giovannitarter/automatic_irrigation/board/mk2/automatic_irrigation_project/automatic_irrigation_project.pdf

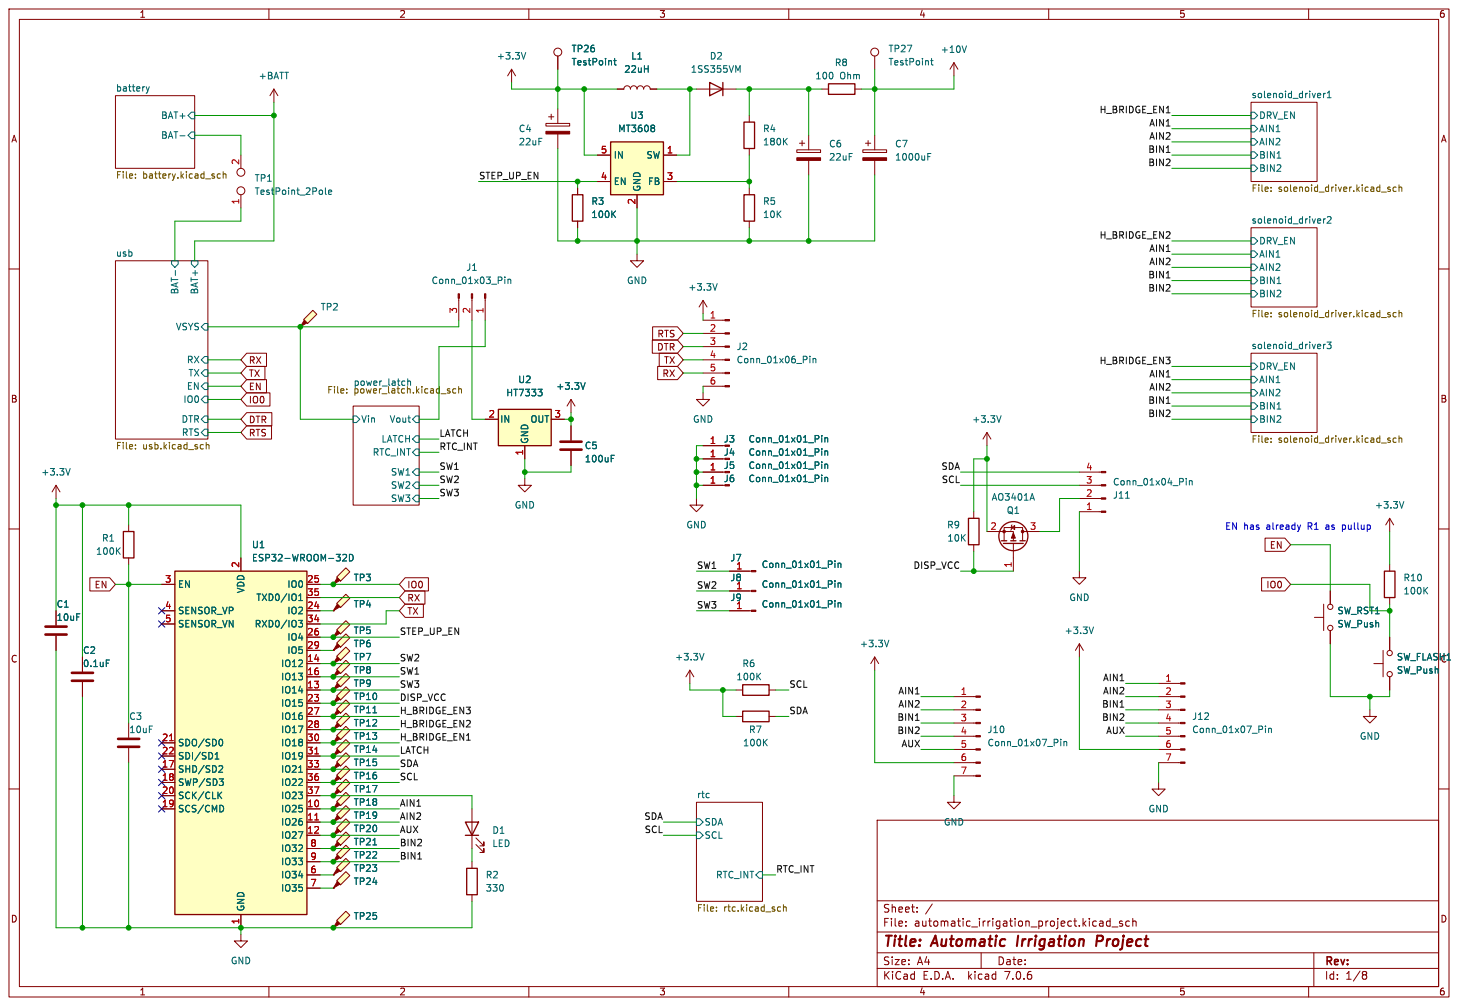
[picture p1: page 1]

2 SCK/CLK 20 SDO/SD0 21 SDI/SD1 22

Id: 1/8 Title: Automatic Irrigation Project File: automatic_irrigation_project.kicad_sch Sheet: /

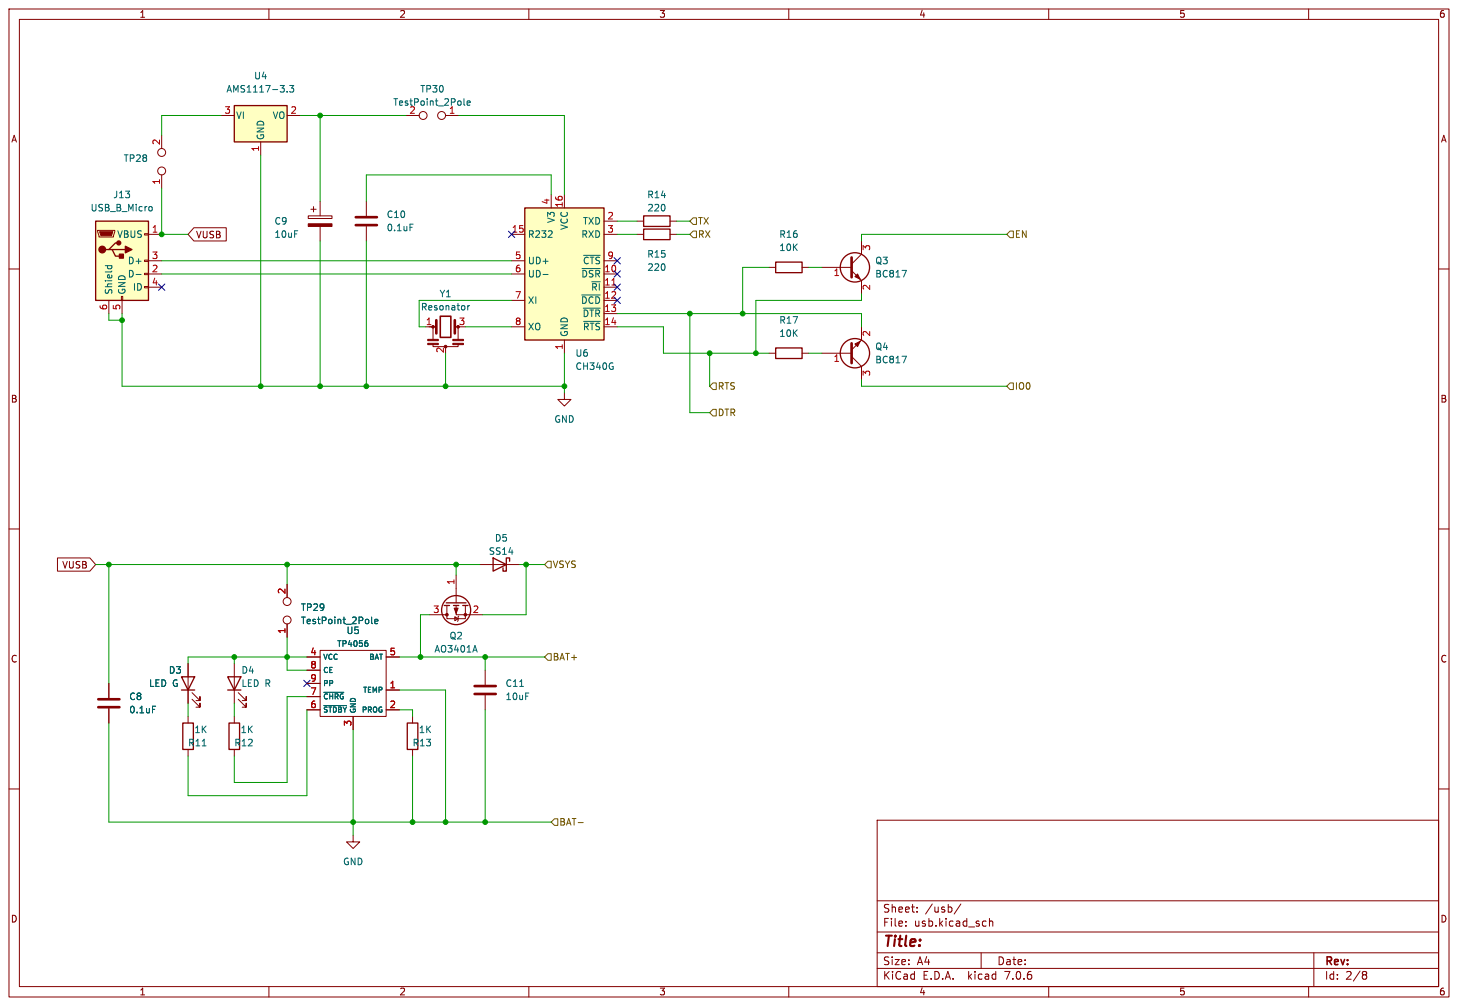
[picture p2: page 2]

1 ~{DSR} 10 ~{RI} 11 ~{DCD} 12 ~{DTR} 13 ~{RTS} 14 R232 15 VCC 16 TXD 2 RXD 3 V3

4 UD+ 5 UD- 6 XI 7 XO 8 ~{CTS}9 U6 CH340G

Id: 2/8 Title: File: usb.kicad_sch Sheet: /usb/

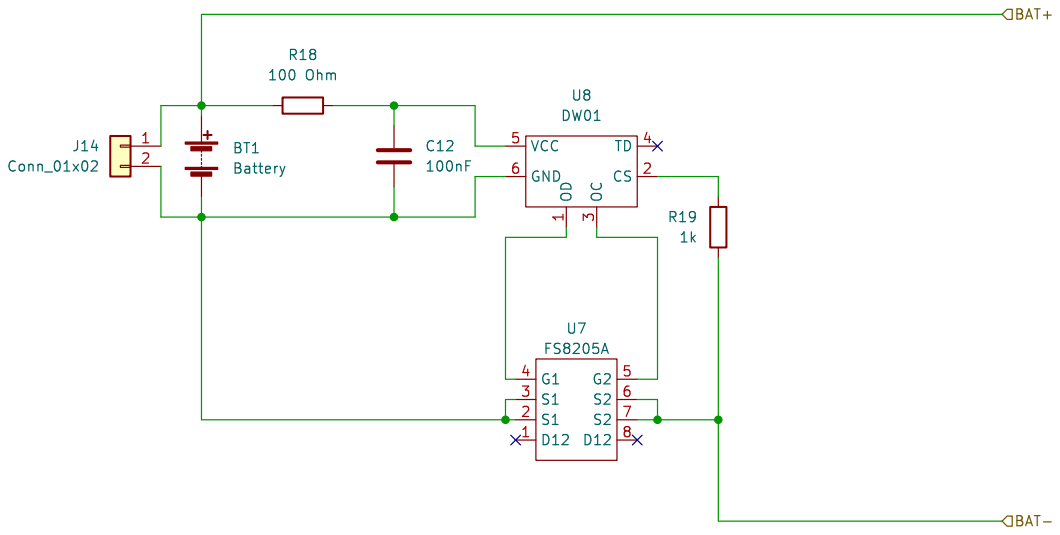
[picture p3: page 3]

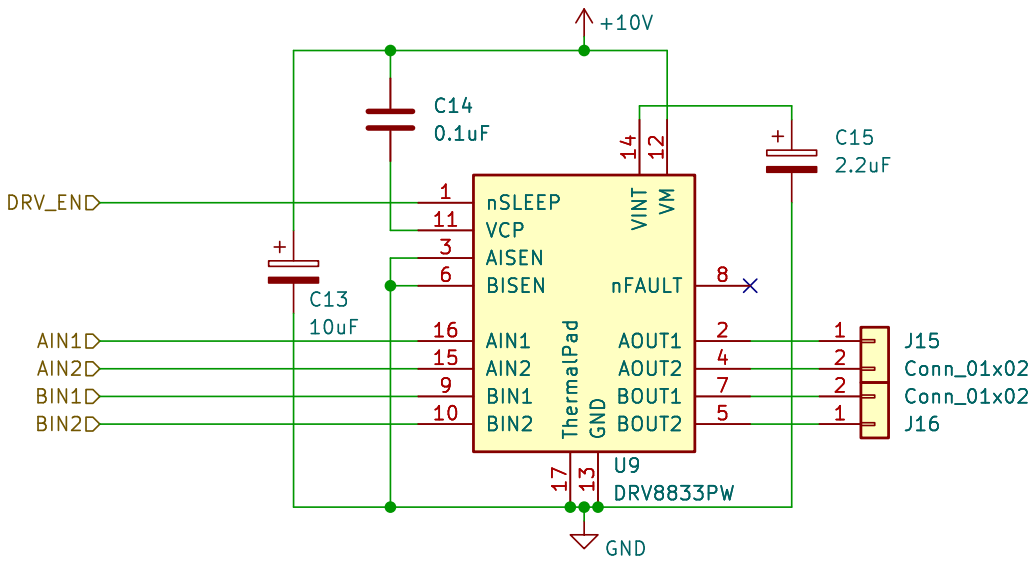
[picture p4: page 4]

Id: 4/8 Title: File: solenoid_driver.kicad_sch Sheet: /solenoid_driver1/ C13

2 2
1 1

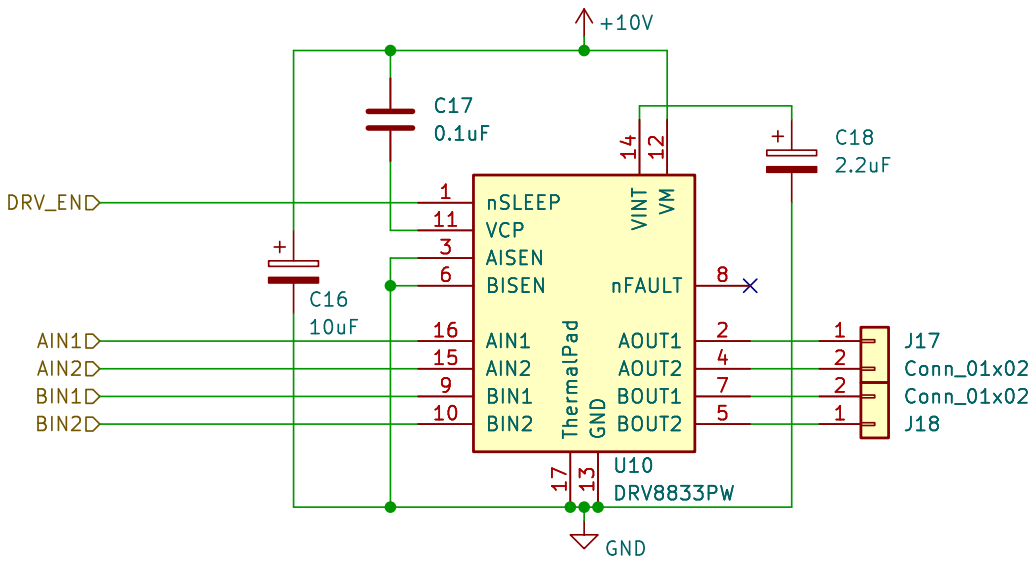
[picture p5: page 5]

Id: 5/8 Title: File: solenoid_driver.kicad_sch Sheet: /solenoid_driver2/ C16

2 2
1 1

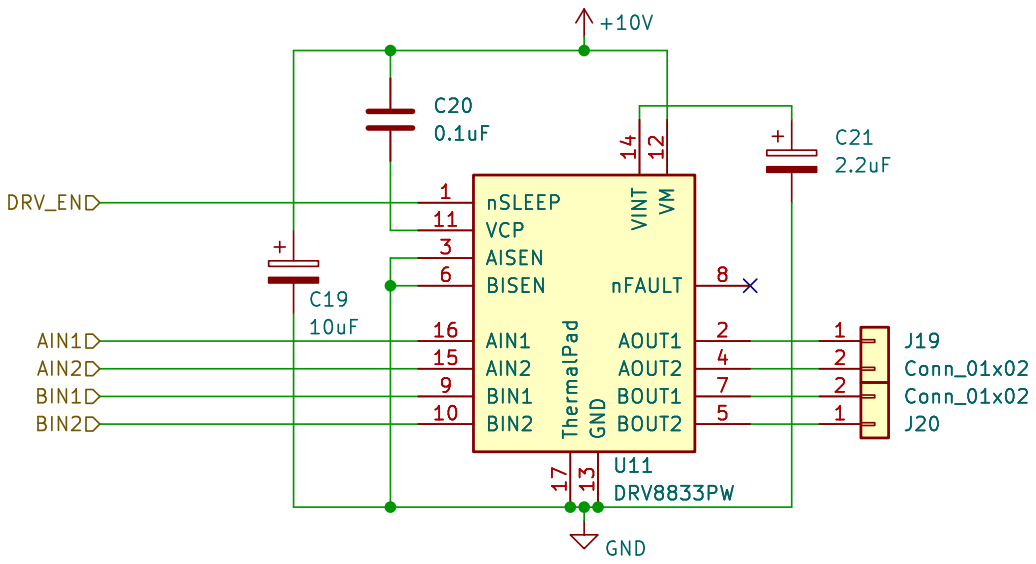
[picture p6: page 6]

Id: 6/8 Title: File: solenoid_driver.kicad_sch Sheet: /solenoid_driver3/ C19

2 2
1 1

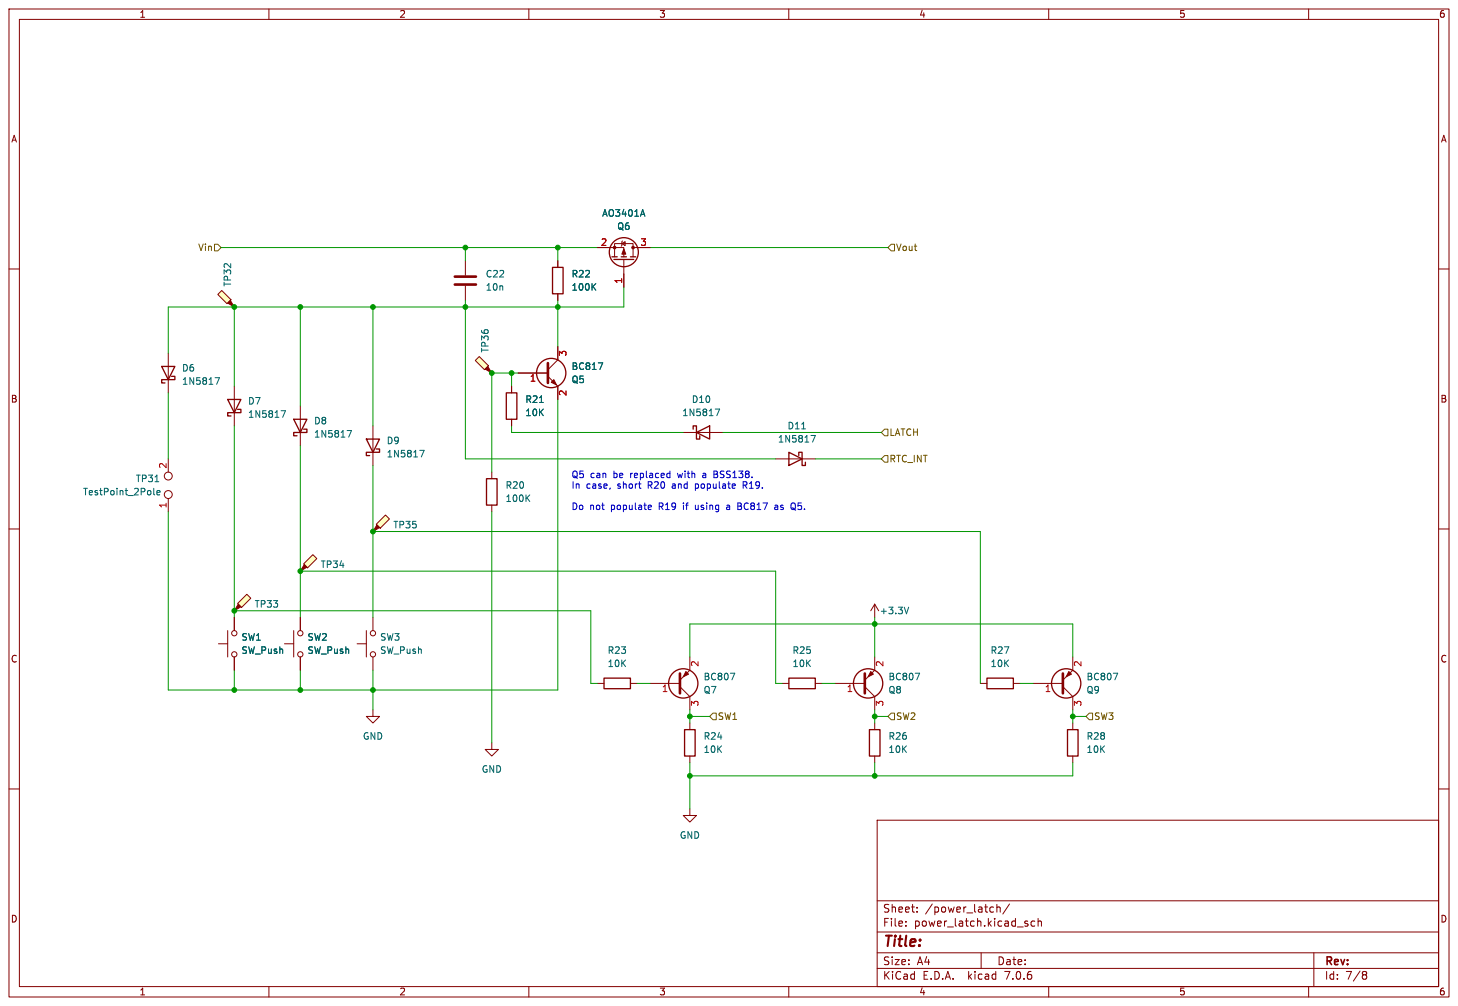
[picture p7: page 7]

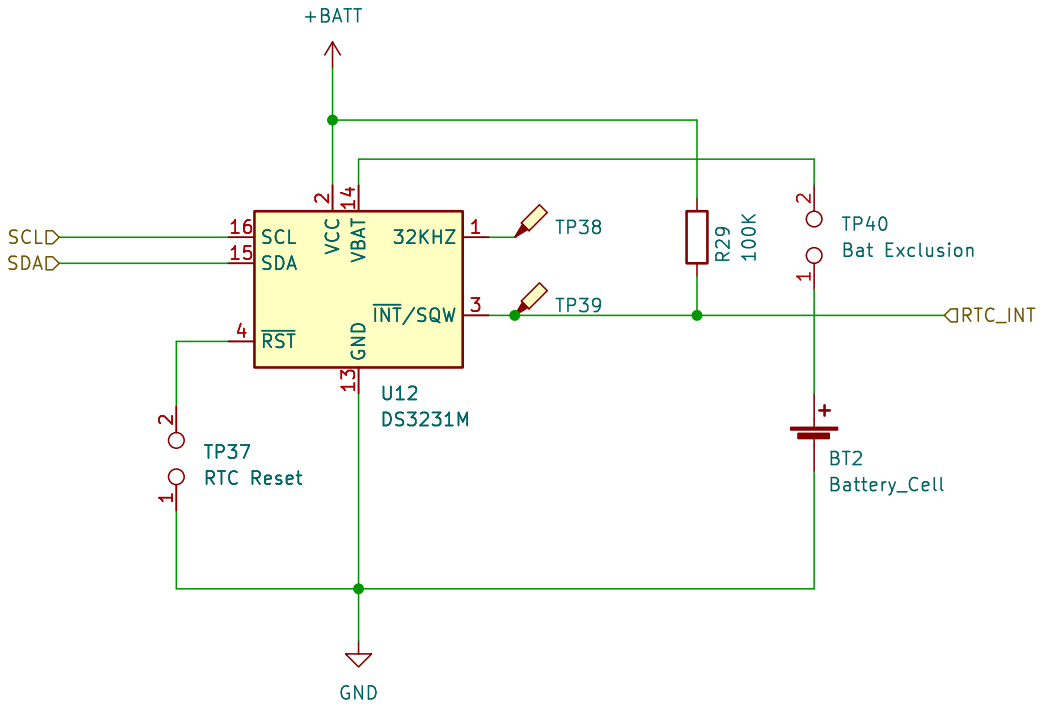
[picture p8: page 8]

Id: 8/8 Title: File: rtc.kicad_sch Sheet: /rtc/
