giovannitarter/automatic_irrigation/board/mk1/garden_valve_controller/garden_valve_controller.pdf

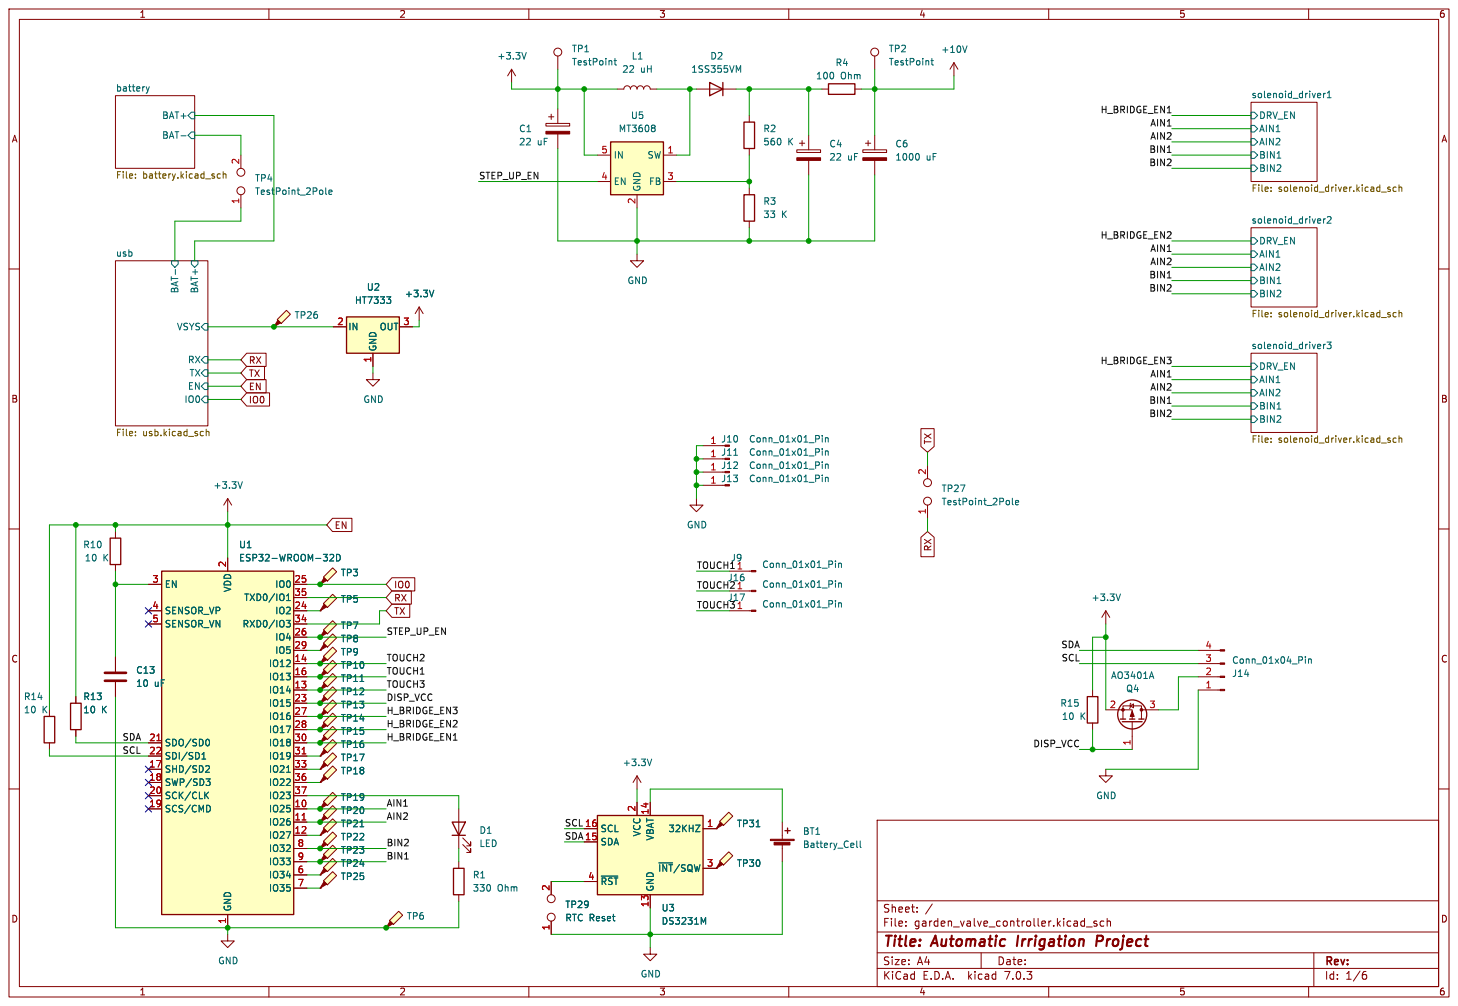
[picture p9: page 1]

2 SCK/CLK 20 SDO/SD0 21 SDI/SD1 22

2 ~{INT}/SQW3 ~{RST} 4 TP29 RTC Reset 1 2

Id: 1/6 Title: Automatic Irrigation Project File: garden_valve_controller.kicad_sch Sheet: /

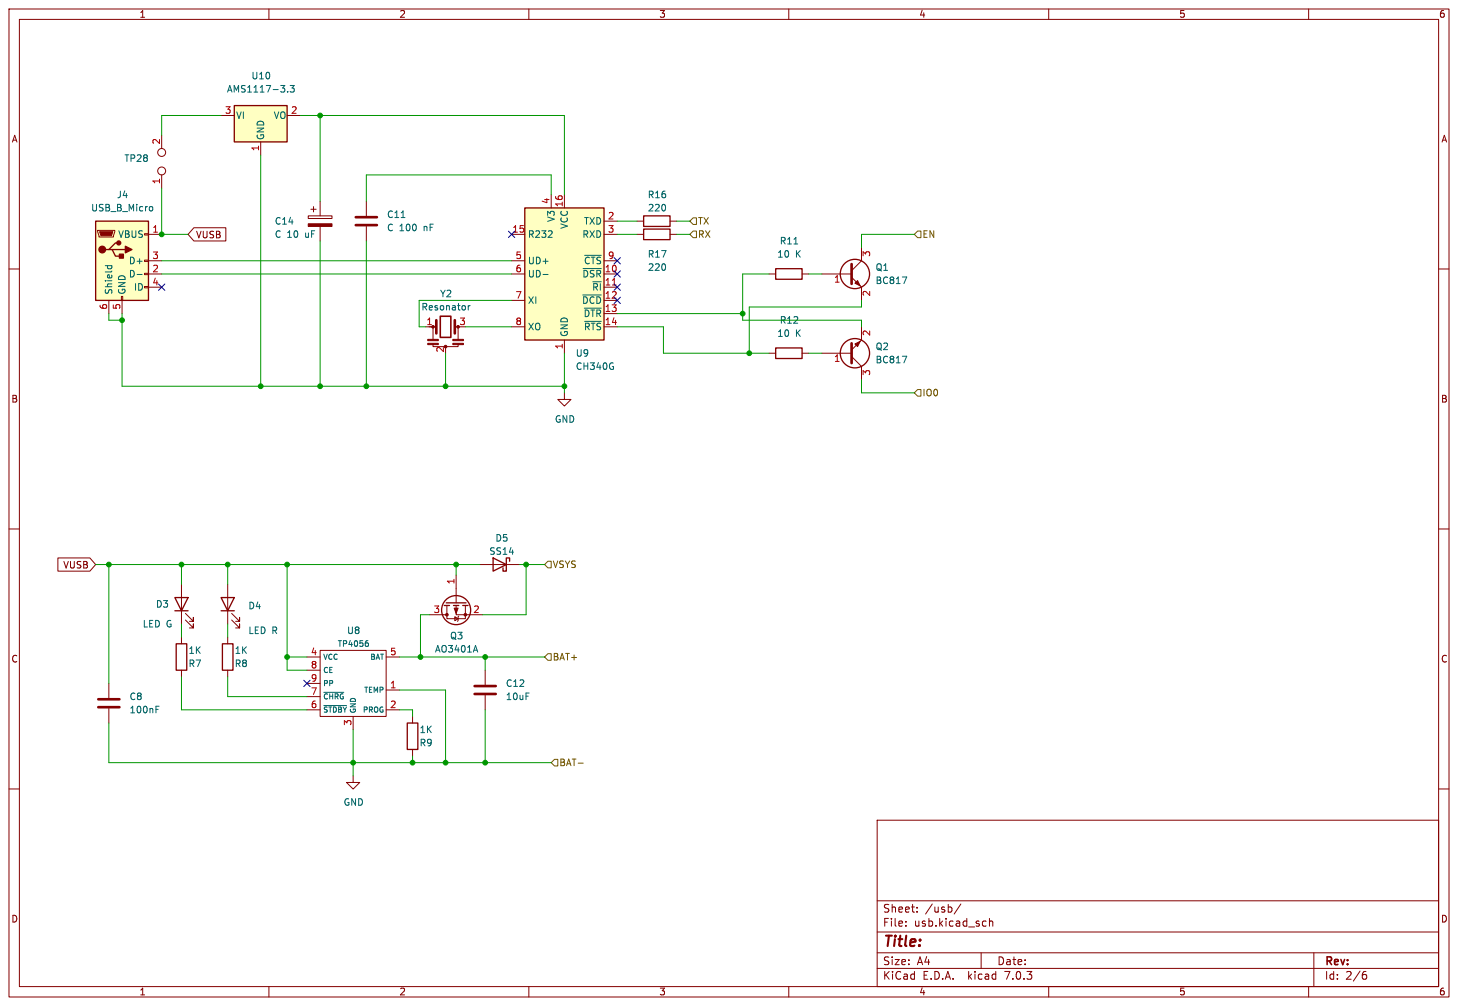
[picture p10: page 2]

1 ~{DSR} 10 ~{RI} 11 ~{DCD} 12 ~{DTR} 13 ~{RTS} 14 R232 15 VCC 16 TXD 2 RXD 3 V3

4 UD+ 5 UD- 6 XI 7 XO 8 ~{CTS}9 U9 CH340G

Id: 2/6 Title: File: usb.kicad_sch Sheet: /usb/

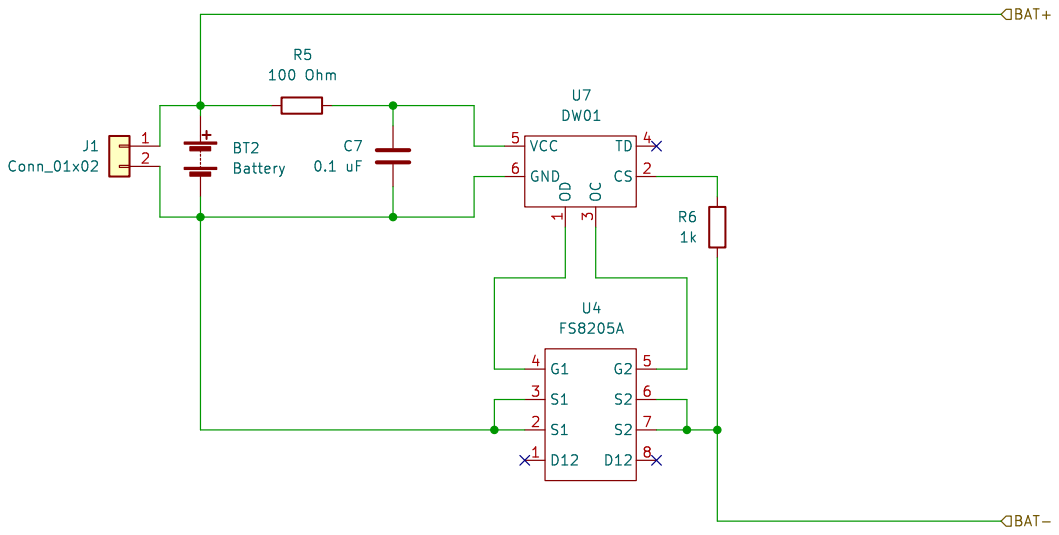
[picture p11: page 3]

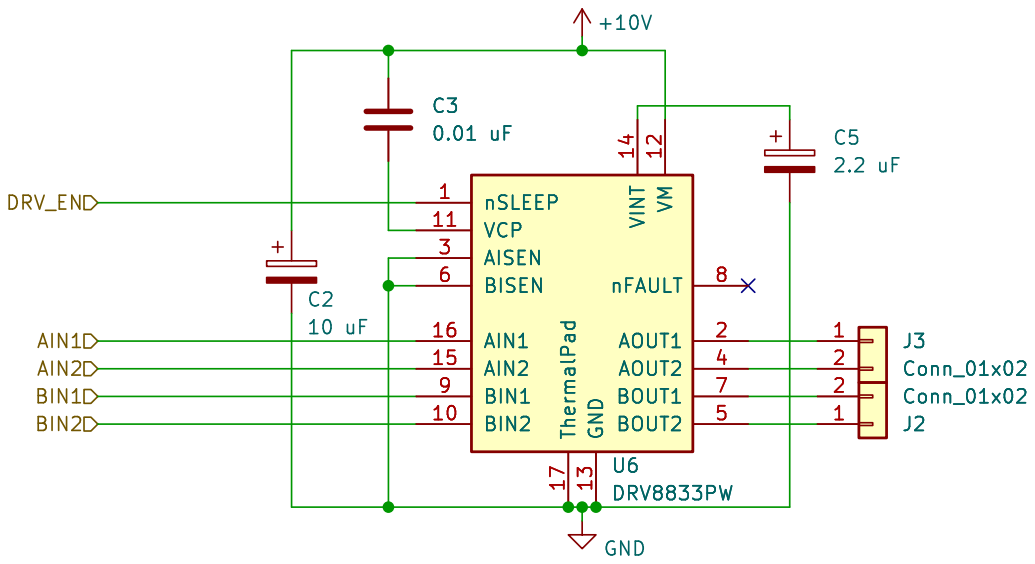
[picture p12: page 4]

Id: 4/6 Title: File: solenoid_driver.kicad_sch Sheet: /solenoid_driver1/ C2

2 2
1 1

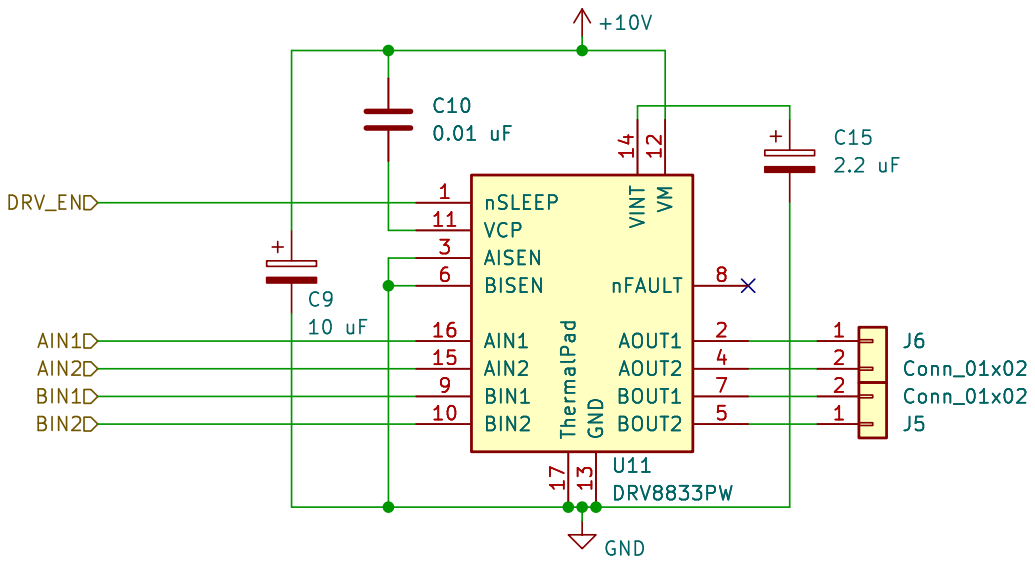
[picture p13: page 5]

Id: 5/6 Title: File: solenoid_driver.kicad_sch Sheet: /solenoid_driver2/ C9

2 2
1 1

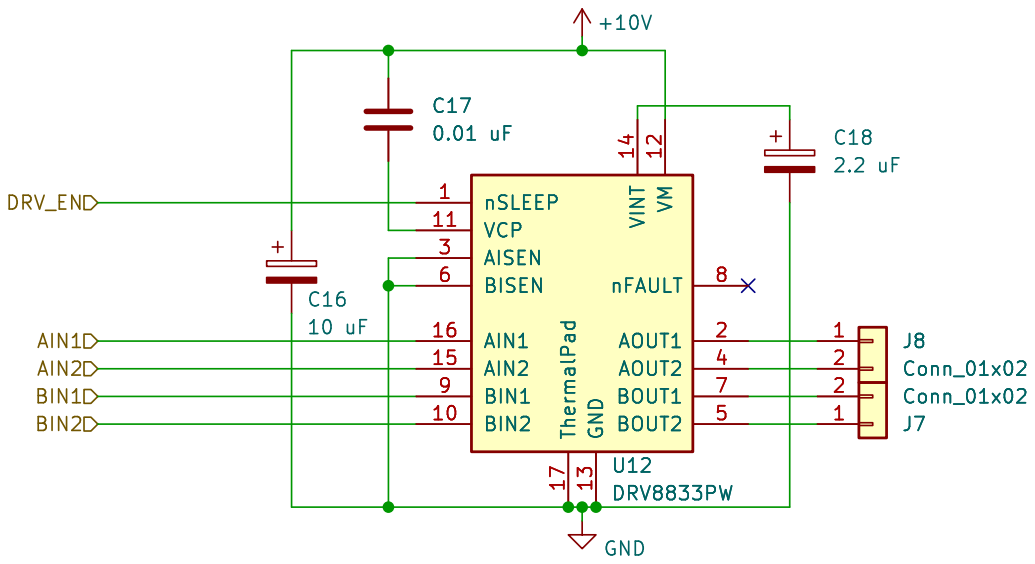
[picture p14: page 6]

Id: 6/6 Title: File: solenoid_driver.kicad_sch Sheet: /solenoid_driver3/ C16

2 2
1 1
