giovannitarter/automatic_irrigation/board/mk2/automatic_irrigation_project/automatic_irrigation_project.kicad_pcb

## KiCad design board/mk2/automatic_irrigation_project/automatic_irrigation_project.kicad_pcb (2023-07-23)

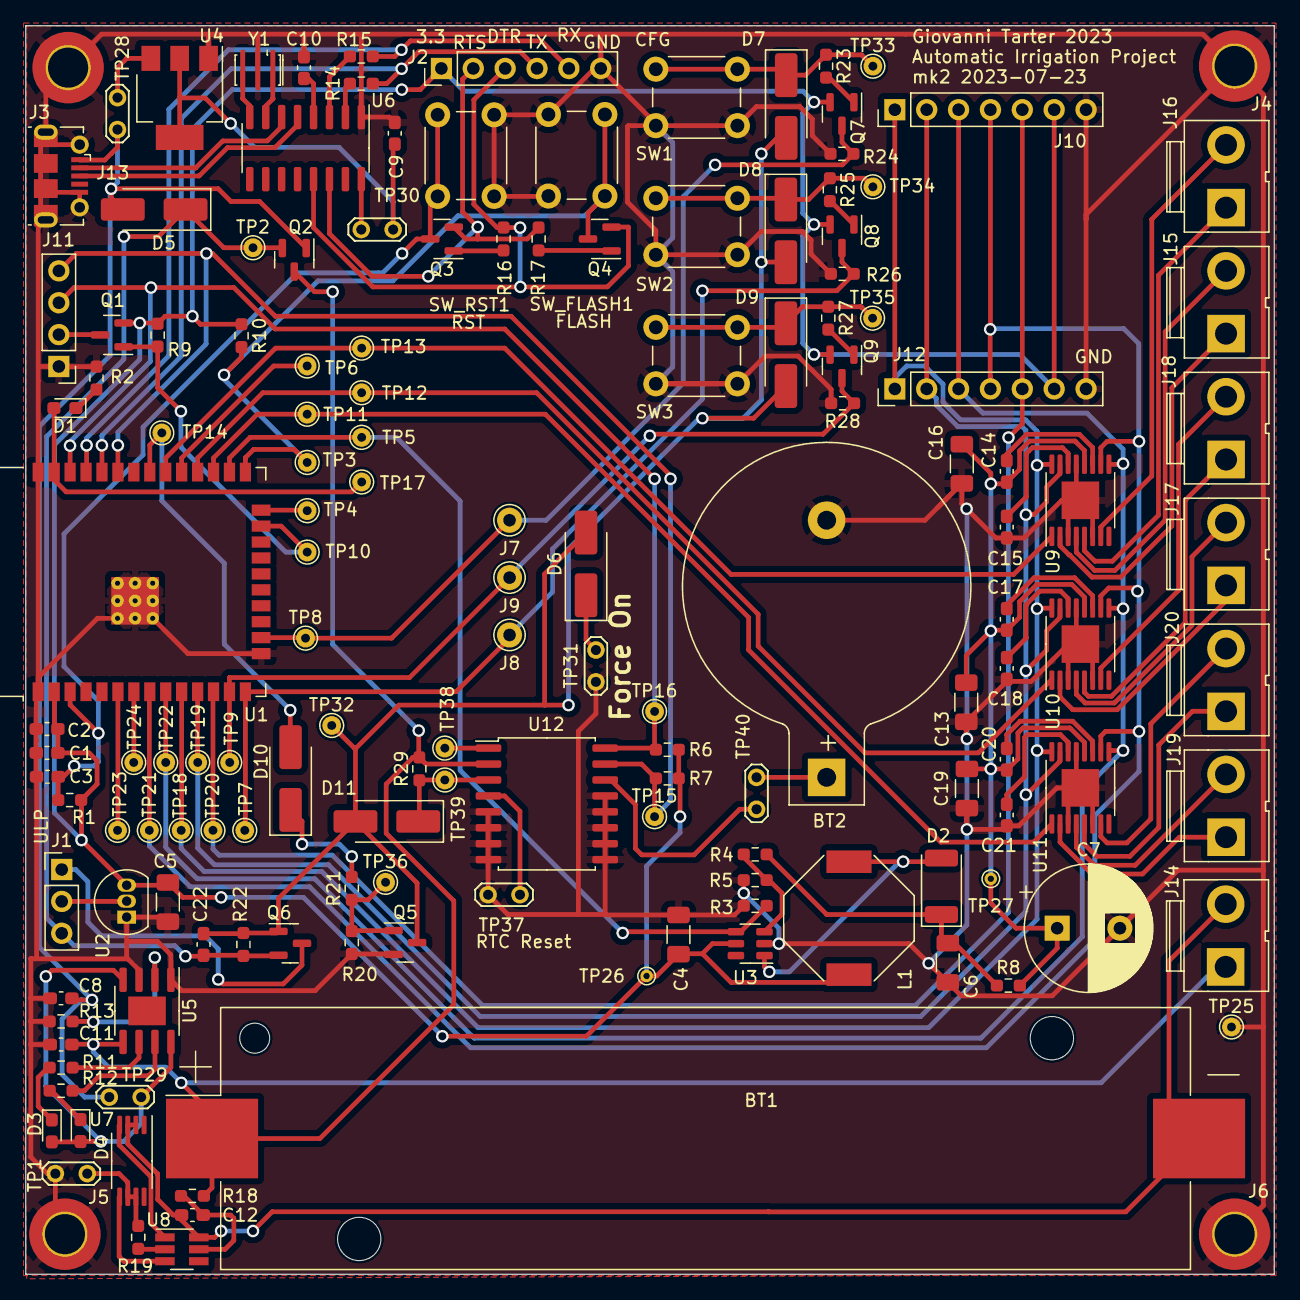
[picture p15: board automatic_irrigation_project.kicad_pcb from above]

Board: 2 copper layers, 99.5 x 99.5 mm, 152 parts (0 on the bottom side), 97 nets.

Parts:
BT1: Battery; BatteryHolder_Keystone_1042_1x18650
BT2: Battery_Cell; BatteryHolder_Keystone_103_1x20mm
C1, C3, C9, C11: 10uF; C_0603_1608Metric_Pad1.08x0.95mm_HandSolder
C2, C8, C10, C14, C17, C20: 0.1uF; C_0603_1608Metric_Pad1.08x0.95mm_HandSolder
C4, C6: 22uF; C_1206_3216Metric_Pad1.33x1.80mm_HandSolder
C5: 100uF; C_1206_3216Metric_Pad1.33x1.80mm_HandSolder
C7: 1000uF; CP_Radial_D10.0mm_P5.00mm
C12: 100nF; C_0603_1608Metric_Pad1.08x0.95mm_HandSolder
C13, C16, C19: 10uF; C_1206_3216Metric_Pad1.33x1.80mm_HandSolder
C15, C18, C21: 2.2uF; C_0603_1608Metric_Pad1.08x0.95mm_HandSolder
C22: 10n; C_0603_1608Metric_Pad1.08x0.95mm_HandSolder
D1: LED; LED_0603_1608Metric_Pad1.05x0.95mm_HandSolder
D2: 1SS355VM; D_2010_5025Metric
D3: LED G; LED_0603_1608Metric_Pad1.05x0.95mm_HandSolder
D4: LED R; LED_0603_1608Metric_Pad1.05x0.95mm_HandSolder
D5: SS14; D_SMA_Handsoldering
D6, D7, D8, D9, D10, D11: 1N5817; D_SMA_Handsoldering
J1: Conn_01x03_Pin; PinHeader_1x03_P2.54mm_Vertical
J2: Conn_01x06_Pin; PinHeader_1x06_P2.54mm_Vertical
J3, J4, J5, J6: Conn_01x01_Pin; MountingHole_3.2mm_M3_ISO7380_Pad_TopBottom
J7, J8, J9: Conn_01x01_Pin; Pin_D1.0mm_L10.0mm
J10, J12: Conn_01x07_Pin; PinHeader_1x07_P2.54mm_Vertical
J11: Conn_01x04_Pin; PinHeader_1x04_P2.54mm_Vertical
J13: USB_B_Micro; USB_Micro-B_Molex-105017-0001
J14, J15, J16, J17, J18, J19, J20: Conn_01x02; Terminal_5mm
L1: 22uH; L_Bourns-SRU1028_10.0x10.0mm
Q1, Q2, Q6: AO3401A; SOT-23
Q3, Q4, Q5: BC817; SOT-23
Q7, Q8, Q9: BC807; SOT-23
R1, R3, R6, R7, R10, R20, R22, R29: 100K; R_0603_1608Metric_Pad0.98x0.95mm_HandSolder
R2: 330; R_0603_1608Metric_Pad0.98x0.95mm_HandSolder
R4: 180K; R_0603_1608Metric_Pad0.98x0.95mm_HandSolder
R5, R9, R16, R17, R21, R23, R24, R25, R26, R27, R28: 10K; R_0603_1608Metric_Pad0.98x0.95mm_HandSolder
R8, R18: 100 Ohm; R_0603_1608Metric_Pad0.98x0.95mm_HandSolder
R11, R12, R13: 1K; R_0603_1608Metric_Pad0.98x0.95mm_HandSolder
R14, R15: 220; R_0603_1608Metric_Pad0.98x0.95mm_HandSolder
R19: 1k; R_0603_1608Metric_Pad0.98x0.95mm_HandSolder
SW1, SW2, SW3: SW_Push; SW_PUSH_6mm_H4.3mm
SW_FLASH1: SW_Push; SW_PUSH_6mm_H4.3mm
SW_RST1: SW_Push; SW_PUSH_6mm_H4.3mm
TP1, TP28, TP29, TP30, TP31: TestPoint_2Pole; TestPoint_2Pads_Pitch2.54mm_Drill0.8mm
TP2, TP3, TP4, TP5, TP6, TP7, TP8, TP9, TP10, TP11, TP12, TP13, TP14, TP15, TP16, TP17, TP18, TP19, TP20, TP21, TP22, TP23, TP24, TP25, TP32, TP33, TP34, TP35, TP36, TP38, TP39: TestPoint_Probe; TestPoint_THTPad_D1.5mm_Drill0.7mm
TP26, TP27: TestPoint; TestPoint_THTPad_D1.0mm_Drill0.5mm
TP37: RTC Reset; TestPoint_2Pads_Pitch2.54mm_Drill0.8mm
TP40: Bat Exclusion; TestPoint_2Pads_Pitch2.54mm_Drill0.8mm
U1: ESP32-WROOM-32D
U2: HT7333; TO-92L_Inline
U3: MT3608; SOT-23-6
U4: AMS1117-3.3; SOT-223-3_TabPin2
U5: TP4056; SOIC-8-1EP_3.9x4.9mm_P1.27mm_EP2.29x3mm
U6: CH340G; SOIC-16_3.9x9.9mm_P1.27mm
U7: FS8205A; TSSOP-8_4.4x3mm_P0.65mm
U8: DW01; SOT-23-6_Handsoldering
U9, U10, U11: DRV8833PW; HTSSOP-16-1EP_4.4x5mm_P0.65mm_EP3x3mm
U12: DS3231M; SOIC-16W_7.5x10.3mm_P1.27mm
Y1: Resonator; Resonator_SMD_Murata_CSTxExxV-3Pin_3.0x1.1mm_HandSoldering

Connections:
+3.3V: C1.1, C2.1, C4.1, C5.1, J2.1, J10.6, J12.6, L1.1, Q1.2 (S), Q7.2 (E), Q8.2 (E), Q9.2 (E), R1.2, R6.1, R7.1, R9.2, R10.1, TP26.1, U1.2 (VDD), U2.3 (OUT), U3.5 (IN)
+10V: C7.1, C13.1, C14.1, C16.1, C17.1, C19.1, C20.1, R8.2, TP27.1, U9.12 (VM), U10.12 (VM), U11.12 (VM)
+BATT: BT1.1 (+), C11.1, J14.1, Q2.3 (D), R18.2, R29.2, U5.5 (BAT), U12.2 (VCC)
/AIN1: J10.1, J12.1, TP18.1, U1.10 (IO25), U9.16 (AIN1), U10.16 (AIN1), U11.16 (AIN1)
/AIN2: J10.2, J12.2, TP19.1, U1.11 (IO26), U9.15 (AIN2), U10.15 (AIN2), U11.15 (AIN2)
/AUX: J10.5, J12.5, TP20.1, U1.12 (IO27)
/BIN1: J10.3, J12.3, TP22.1, U1.9 (IO33), U9.9 (BIN1), U10.9 (BIN1), U11.9 (BIN1)
/BIN2: J10.4, J12.4, TP21.1, U1.8 (IO32), U9.10 (BIN2), U10.10 (BIN2), U11.10 (BIN2)
/DISP_VCC: Q1.1 (G), R9.1, TP10.1, U1.23 (IO15)
/H_BRIDGE_EN1: TP13.1, U1.30 (IO18), U9.1 (nSLEEP)
/H_BRIDGE_EN2: TP12.1, U1.28 (IO17), U10.1 (nSLEEP)
/H_BRIDGE_EN3: TP11.1, U1.27 (IO16), U11.1 (nSLEEP)
/LATCH: D10.2 (A), TP14.1, U1.31 (IO19)
/RTC_INT: D11.1 (K), R29.1, TP39.1, U12.3 (~INT/SQW)
/SCL: J11.3, R6.2, TP16.1, U1.36 (IO22), U12.16 (SCL)
/SDA: J11.4, R7.2, TP15.1, U1.33 (IO21), U12.15 (SDA)
/STEP_UP_EN: R3.1, TP5.1, U1.26 (IO4), U3.4 (EN)
/SW1: J7.1, Q7.3 (C), R24.1, TP8.1, U1.16 (IO13)
/SW2: J8.1, Q8.3 (C), R26.1, TP7.1, U1.14 (IO12)
/SW3: J9.1, Q9.3 (C), R28.1, TP9.1, U1.13 (IO14)
/battery/BAT-: R19.2, TP1.2, U7.6 (S2), U7.7 (S2)
/power_latch/Vin: C22.1, D5.1 (K), J1.3, Q2.2 (S), Q6.2 (S), R22.2, TP2.1
/power_latch/Vout: J1.1, Q6.3 (D)
DTR: J2.3, Q4.2 (E), R16.1, U6.13 (~DTR)
EN: C3.1, Q3.3 (C), R1.1, SW_RST1.2, U1.3 (EN)
GND: BT2.2 (-), C1.2, C2.2, C3.2, C4.2, C5.2, C6.2, C7.2, C8.2, C9.2, C10.2, C11.2, C13.2, C15.2, C16.2, C18.2, C19.2, C21.2, J2.6, J3.1, J4.1, J5.1, J6.1, J10.7, J11.1, J12.7, J13.5 (GND), J13.6 (Shield), Q5.2 (E), R2.2, R3.2, R5.2, R13.1, R20.2, R24.2, R26.2, R28.2, SW1.1, SW2.1, SW3.1, SW_FLASH1.1, SW_RST1.1, TP1.1, TP25.1, TP31.1, TP37.1, U1.1 (GND), U1.15 (GND), U1.38 (GND), U1.39 (GND), U2.1 (GND), U3.2 (GND), U4.1 (GND), U5.1 (TEMP), U5.3 (GND), U6.1 (GND), U9.3 (AISEN), U9.6 (BISEN), U9.13 (GND), U9.17 (ThermalPad), U10.3 (AISEN), U10.6 (BISEN), U10.13 (GND), U10.17 (ThermalPad), U11.3 (AISEN), U11.6 (BISEN), U11.13 (GND), U11.17 (ThermalPad), U12.5 (GND), U12.6 (GND), U12.7 (GND), U12.8 (GND), U12.9 (GND), U12.10 (GND), U12.11 (GND), U12.12 (GND), U12.13 (GND), Y1.2
IO0: Q4.3 (C), R10.2, SW_FLASH1.2, TP3.1, U1.25 (IO0)
unnamed: BT1.2 (-), C12.2, J14.2, U7.2 (S1), U7.3 (S1), U8.6 (GND)
unnamed: BT2.1 (+), TP40.1
unnamed: D1.2 (A), TP17.1, U1.37 (IO23)
unnamed: D1.1 (K), R2.1
unnamed: D2.2 (A), L1.2, U3.1 (SW)
unnamed: C6.1, D2.1 (K), R4.1, R8.1
unnamed: D3.2 (A), D4.2 (A), TP29.1, U5.4 (VCC), U5.8 (CE)
unnamed: D3.1 (K), R11.2
unnamed: D4.1 (K), R12.2
unnamed: D6.1 (K), TP31.2
unnamed: D7.1 (K), R23.1, SW1.2, TP33.1
unnamed: D8.1 (K), R25.1, SW2.2, TP34.1
unnamed: D9.1 (K), R27.1, SW3.2, TP35.1
unnamed: D10.1 (K), R21.2
unnamed: C22.2, D6.2 (A), D7.2 (A), D8.2 (A), D9.2 (A), D11.2 (A), Q5.3 (C), Q6.1 (G), R22.1, TP32.1
unnamed: J1.2, U2.2 (IN)
unnamed: J11.2, Q1.3 (D)
unnamed: J13.3 (D+), U6.5 (UD+)
unnamed: J13.2 (D-), U6.6 (UD-)
unnamed: J15.1, U9.2 (AOUT1)
unnamed: J15.2, U9.4 (AOUT2)
unnamed: J16.1, U9.5 (BOUT2)
unnamed: J16.2, U9.7 (BOUT1)
unnamed: J17.1, U10.2 (AOUT1)
unnamed: J17.2, U10.4 (AOUT2)
unnamed: J18.1, U10.5 (BOUT2)
unnamed: J18.2, U10.7 (BOUT1)
unnamed: J19.1, U11.2 (AOUT1)
unnamed: J19.2, U11.4 (AOUT2)
unnamed: J20.1, U11.5 (BOUT2)
unnamed: J20.2, U11.7 (BOUT1)
unnamed: Q3.1 (B), R16.2
unnamed: Q4.1 (B), R17.2
unnamed: Q5.1 (B), R20.1, R21.1, TP36.1
unnamed: Q7.1 (B), R23.2
unnamed: Q8.1 (B), R25.2
unnamed: Q9.1 (B), R27.2
unnamed: TP4.1, U1.24 (IO2)
unnamed: TP6.1, U1.29 (IO5)
unnamed: TP23.1, U1.6 (IO34)
unnamed: TP24.1, U1.7 (IO35)
unnamed: R4.2, R5.1, U3.3 (FB)
unnamed: TP28.2, U4.3 (VI)
unnamed: C9.1, TP30.2, U4.2 (VO)
unnamed: R13.2, U5.2 (PROG)
unnamed: R12.1, U5.7 (~CHRG)
unnamed: R11.1, U5.6 (~STDBY)
unnamed: R15.1, U6.3 (RXD)
unnamed: R14.1, U6.2 (TXD)
unnamed: C10.1, U6.4 (V3)
unnamed: TP30.1, U6.16 (VCC)
unnamed: U6.7 (XI), Y1.1
unnamed: U6.8 (XO), Y1.3
unnamed: U7.4 (G1), U8.1 (OD)
unnamed: U7.5 (G2), U8.3 (OC)
unnamed: R19.1, U8.2 (CS)
unnamed: C12.1, R18.1, U8.5 (VCC)
unnamed: C14.2, U9.11 (VCP)
unnamed: C15.1, U9.14 (VINT)
unnamed: C17.2, U10.11 (VCP)
unnamed: C18.1, U10.14 (VINT)
unnamed: C20.2, U11.11 (VCP)
unnamed: C21.1, U11.14 (VINT)
unnamed: TP38.1, U12.1 (32KHZ)
unnamed: TP40.2, U12.14 (VBAT)
unnamed: TP37.2, U12.4 (~RST)
RTS: J2.2, Q3.2 (E), R17.1, U6.14 (~RTS)
RX: J2.5, R15.2, U1.35 (TXD0/IO1)
TX: J2.4, R14.2, U1.34 (RXD0/IO3)
VUSB: C8.1, D5.2 (A), J13.1 (VBUS), Q2.1 (G), TP28.1, TP29.2
