giovannitarter/automatic_irrigation/board/mk1/garden_valve_controller/garden_valve_controller.kicad_pcb

## KiCad design board/mk1/garden_valve_controller/garden_valve_controller.kicad_pcb (2023-05-14, an earlier design)

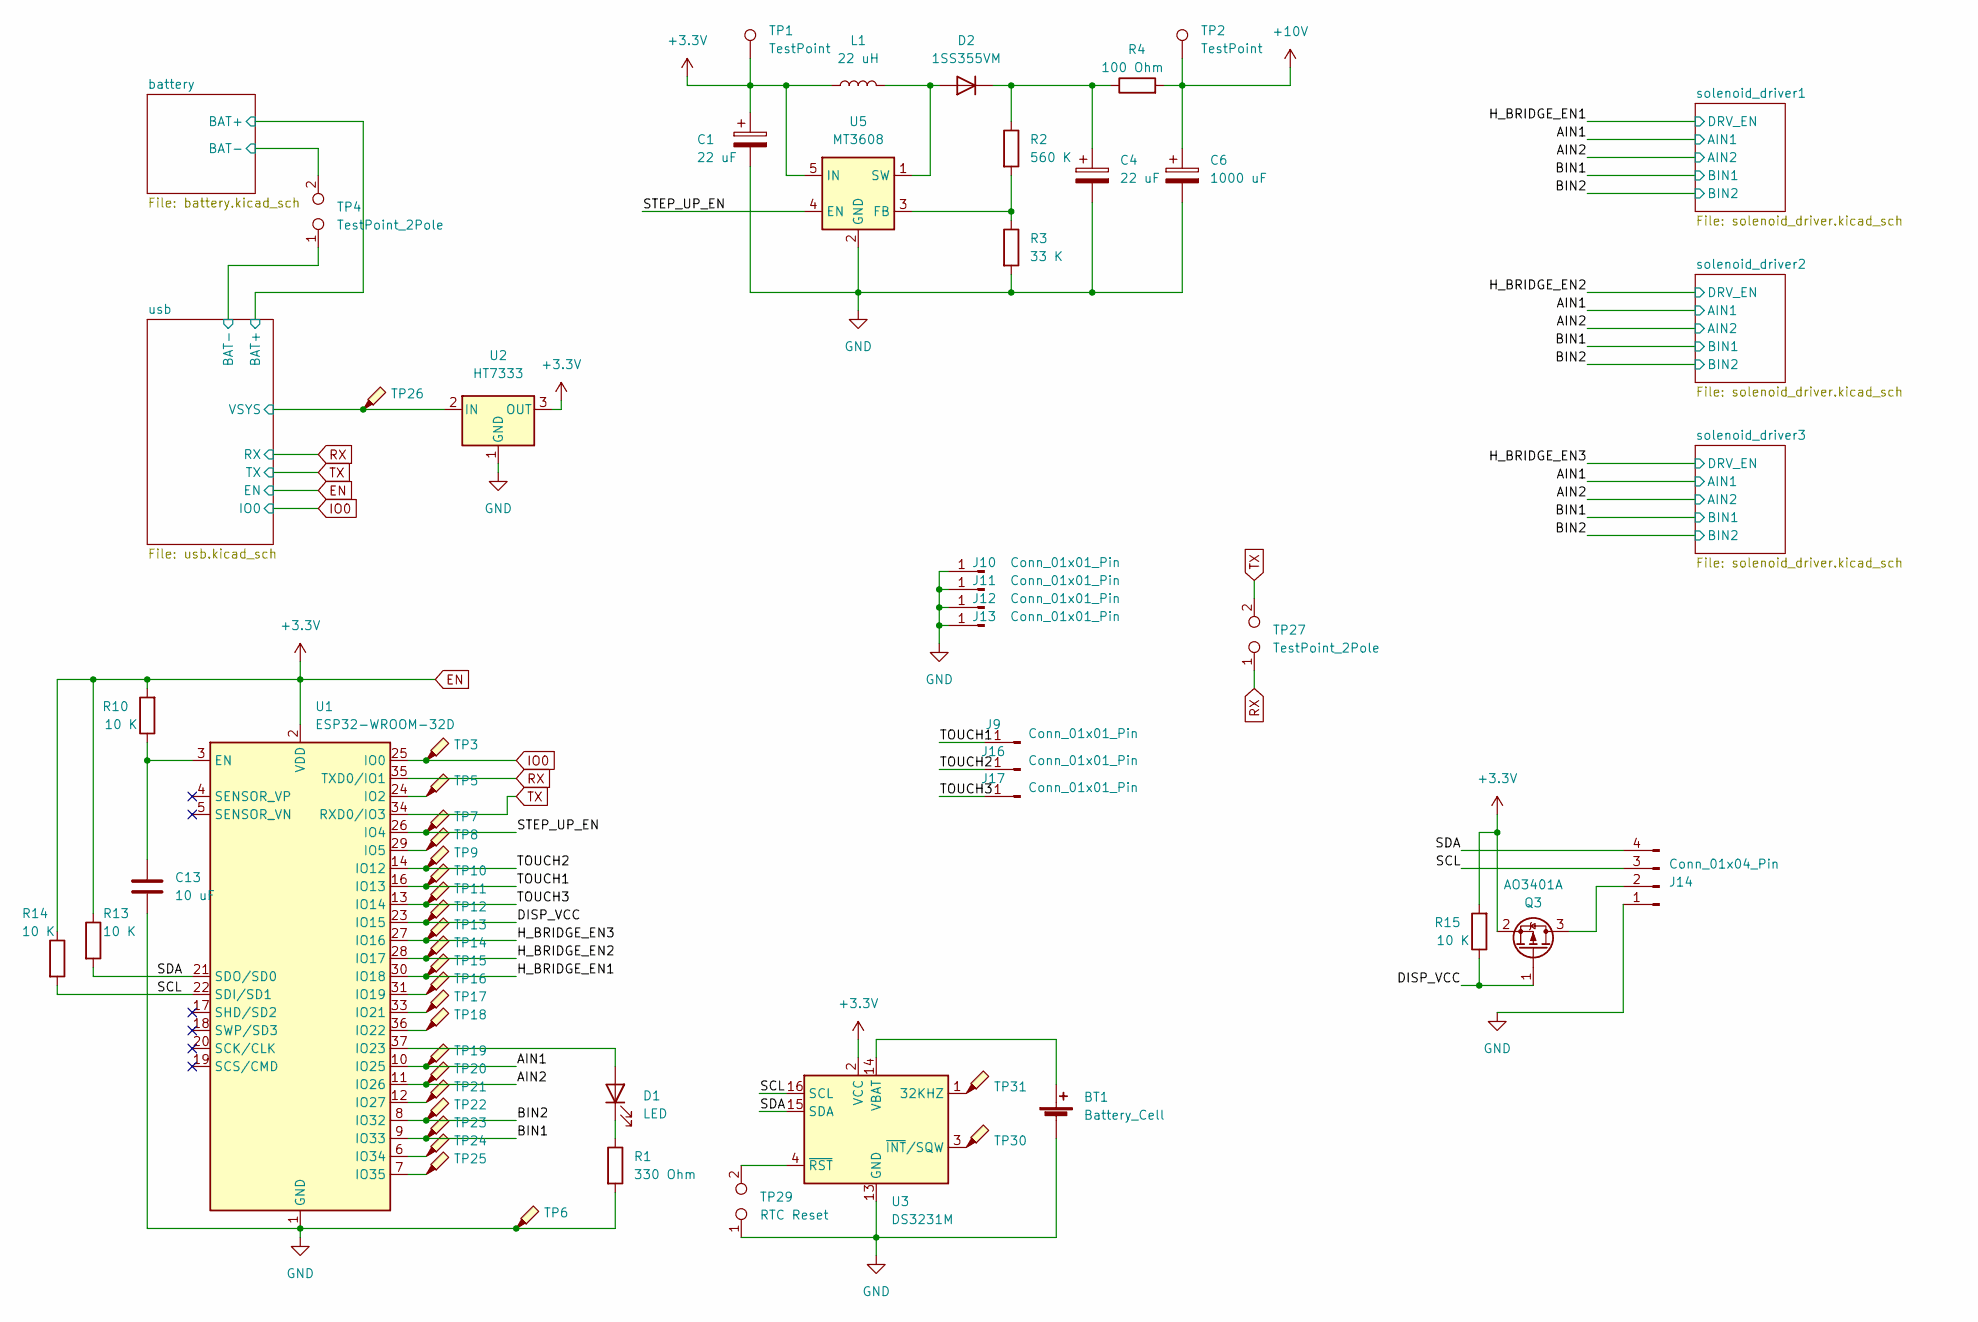
[picture p16: schematic garden_valve_controller.kicad_sch]

Parts:
BT1: Battery_Cell; BatteryHolder_Keystone_103_1x20mm
C1, C4: 22 uF; C_1206_3216Metric_Pad1.33x1.80mm_HandSolder
C6: 1000 uF; CP_Radial_D10.0mm_P5.00mm
C13: 10 uF; C_0603_1608Metric_Pad1.08x0.95mm_HandSolder
D1: LED; LED_D3.0mm_Clear
D2: 1SS355VM; D_2010_5025Metric
J9, J16, J17: Conn_01x01_Pin; Pin_D1.0mm_L10.0mm
J10, J11, J12, J13: Conn_01x01_Pin; MountingHole_3.2mm_M3_ISO7380_Pad_TopBottom
J14: Conn_01x04_Pin; PinHeader_1x04_P2.54mm_Vertical
L1: 22 uH; L_Bourns-SRU1028_10.0x10.0mm
Q3: AO3401A; SOT-23
R1: 330 Ohm; R_0603_1608Metric_Pad0.98x0.95mm_HandSolder
R2: 560 K; R_0603_1608Metric_Pad0.98x0.95mm_HandSolder
R3: 33 K; R_0603_1608Metric_Pad0.98x0.95mm_HandSolder
R4: 100 Ohm; R_0603_1608Metric_Pad0.98x0.95mm_HandSolder
R10, R13, R14, R15: 10 K; R_0603_1608Metric_Pad0.98x0.95mm_HandSolder
TP1, TP2: TestPoint; TestPoint_THTPad_D1.0mm_Drill0.5mm
TP3, TP5, TP6, TP7, TP8, TP9, TP10, TP11, TP12, TP13, TP14, TP15, TP16, TP17, TP18, TP19, TP20, TP21, TP22, TP23, TP24, TP25, TP26, TP30, TP31: TestPoint_Probe; TestPoint_THTPad_D1.0mm_Drill0.5mm
TP4, TP27: TestPoint_2Pole; TestPoint_2Pads_Pitch2.54mm_Drill0.8mm
TP29: RTC Reset; TestPoint_2Pads_Pitch2.54mm_Drill0.8mm
U1: ESP32-WROOM-32D
U2: HT7333; TO-92L_Inline
U3: DS3231M; SOIC-16W_7.5x10.3mm_P1.27mm
U5: MT3608; SOT-23-6

Connections:
+10V: C6.1, R4.2, TP2.1; also elsewhere on the board
/AIN1: TP19.1, U1.10 (IO25); also elsewhere on the board
/AIN2: TP20.1, U1.11 (IO26); also elsewhere on the board
/BIN1: TP23.1, U1.9 (IO33); also elsewhere on the board
/BIN2: TP22.1, U1.8 (IO32); also elsewhere on the board
/H_BRIDGE_EN1: TP15.1, U1.30 (IO18); also elsewhere on the board
/H_BRIDGE_EN2: TP14.1, U1.28 (IO17); also elsewhere on the board
/H_BRIDGE_EN3: TP13.1, U1.27 (IO16); also elsewhere on the board
/SCL: J14.3, R14.2, U1.22 (SDI/SD1), U3.16 (SCL)
/SDA: J14.4, R13.2, U1.21 (SDO/SD0), U3.15 (SDA)
/STEP_UP_EN: TP7.1, U1.26 (IO4), U5.4 (EN)
/TOUCH1: J9.1, TP10.1, U1.16 (IO13)
/TOUCH2: J16.1, TP9.1, U1.14 (IO12)
/TOUCH3: J17.1, TP11.1, U1.13 (IO14)
/battery/BAT-: TP4.2; also elsewhere on the board
GND: BT1.2 (-), C1.2, C4.2, C6.2, C13.2, J10.1, J11.1, J12.1, J13.1, J14.1, R1.2, R3.2, TP4.1, TP6.1, TP29.1, U1.1 (GND), U1.15 (GND), U1.38 (GND), U1.39 (GND), U2.1 (GND), U3.5 (GND), U3.6 (GND), U3.7 (GND), U3.8 (GND), U3.9 (GND), U3.10 (GND), U3.11 (GND), U3.12 (GND), U3.13 (GND), U5.2 (GND); also elsewhere on the board
IO0: TP3.1, U1.25 (IO0); also elsewhere on the board
unnamed: BT1.1 (+), U3.14 (VBAT)
unnamed: D1.2 (A), U1.37 (IO23)
unnamed: D1.1 (K), R1.1
unnamed: D2.2 (A), L1.2, U5.1 (SW)
unnamed: C4.1, D2.1 (K), R2.1, R4.1
unnamed: C13.1, R10.1, U1.3 (EN)
unnamed: TP5.1, U1.24 (IO2)
unnamed: TP8.1, U1.29 (IO5)
unnamed: TP16.1, U1.31 (IO19)
unnamed: TP17.1, U1.33 (IO21)
unnamed: TP18.1, U1.36 (IO22)
unnamed: TP21.1, U1.12 (IO27)
unnamed: TP24.1, U1.6 (IO34)
unnamed: TP25.1, U1.7 (IO35)
unnamed: TP31.1, U3.1 (32KHZ)
unnamed: TP30.1, U3.3 (~INT/SQW)
unnamed: TP29.2, U3.4 (~RST)
unnamed: R2.2, R3.1, U5.3 (FB)
RX: TP27.1, U1.35 (TXD0/IO1); also elsewhere on the board
TX: TP27.2, U1.34 (RXD0/IO3); also elsewhere on the board

Parts of its further copies:
Q4: AO3401A; SOT-23

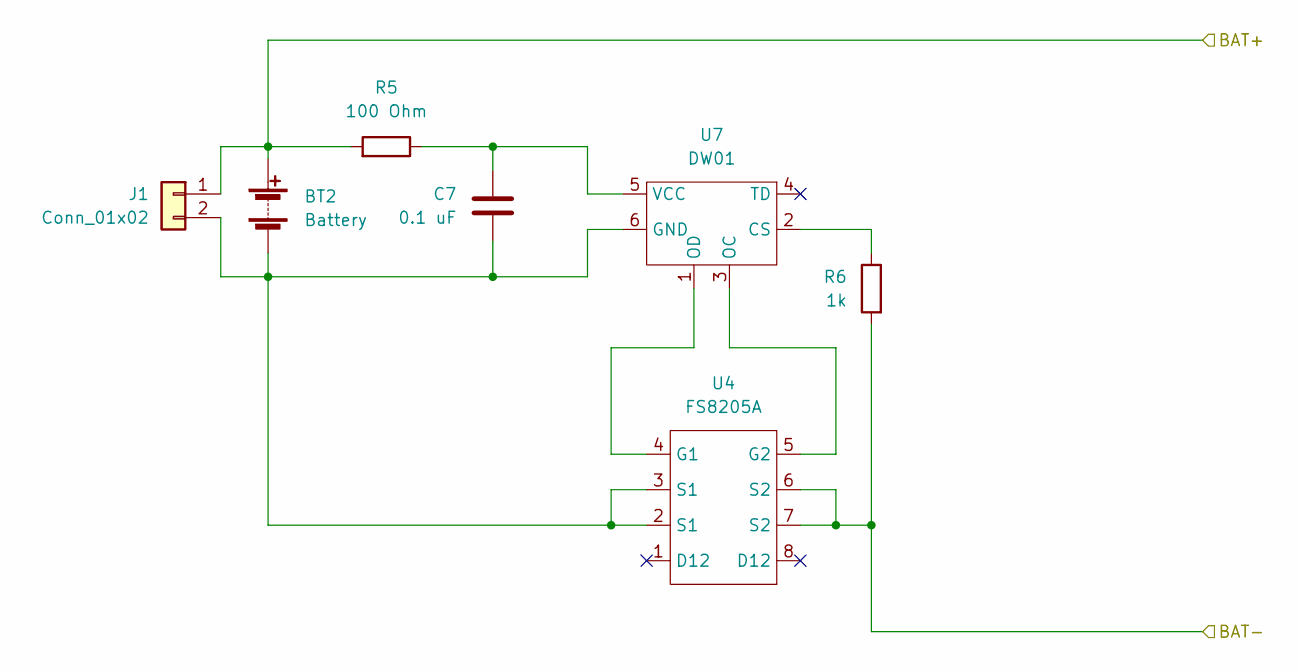
[picture p17: schematic battery.kicad_sch]

Parts:
BT2: Battery; BatteryHolder_MPD_BH-18650-PC2
C7: 0.1 uF; C_0603_1608Metric_Pad1.08x0.95mm_HandSolder
J1: Conn_01x02; Terminal_5mm
R5: 100 Ohm; R_0603_1608Metric_Pad0.98x0.95mm_HandSolder
R6: 1k; R_0603_1608Metric_Pad0.98x0.95mm_HandSolder
U4: FS8205A; TSSOP-8_4.4x3mm_P0.65mm
U7: DW01; SOT-23-6_Handsoldering

Connections:
/battery/BAT-: R6.2, U4.6 (S2), U4.7 (S2); also elsewhere on the board
unnamed: BT2.2 (-), C7.2, J1.2, U4.2 (S1), U4.3 (S1), U7.6 (GND)
unnamed: U4.4 (G1), U7.1 (OD)
unnamed: U4.5 (G2), U7.3 (OC)
unnamed: R6.1, U7.2 (CS)
unnamed: C7.1, R5.1, U7.5 (VCC)

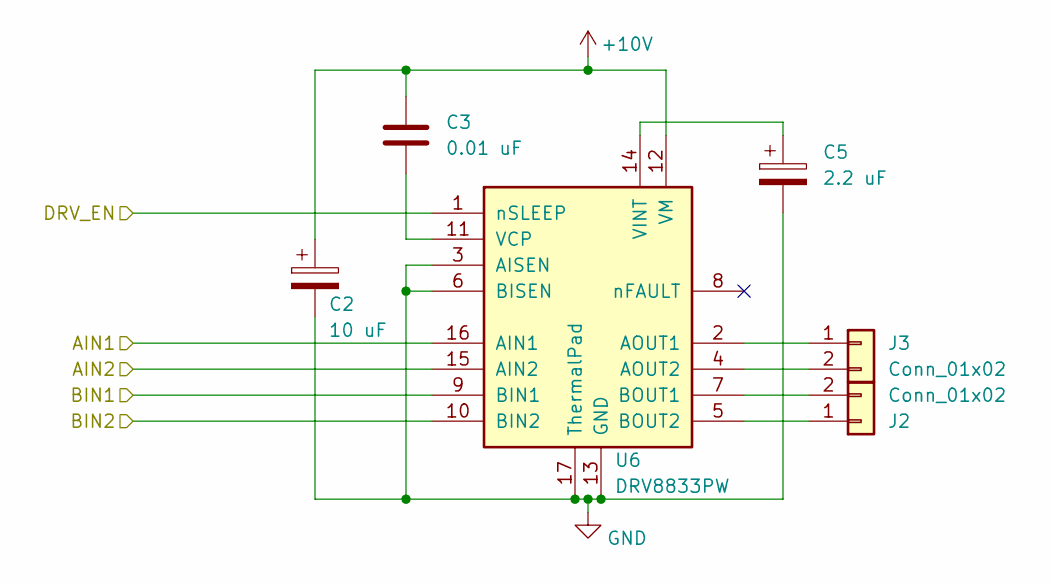
[picture p18: schematic solenoid_driver.kicad_sch]

Parts:
C2: 10 uF; C_1206_3216Metric_Pad1.33x1.80mm_HandSolder
C3: 0.01 uF; C_0603_1608Metric_Pad1.08x0.95mm_HandSolder
C5: 2.2 uF; C_0603_1608Metric_Pad1.08x0.95mm_HandSolder
J2, J3: Conn_01x02; Terminal_5mm
U6: DRV8833PW; HTSSOP-16-1EP_4.4x5mm_P0.65mm_EP3x3mm

Connections:
+10V: C2.1, C3.1, U6.12 (VM); also elsewhere on the board
/AIN1: U6.16 (AIN1); also elsewhere on the board
/AIN2: U6.15 (AIN2); also elsewhere on the board
/BIN1: U6.9 (BIN1); also elsewhere on the board
/BIN2: U6.10 (BIN2); also elsewhere on the board
/H_BRIDGE_EN1: U6.1 (nSLEEP); also elsewhere on the board
GND: C2.2, C5.2, U6.3 (AISEN), U6.6 (BISEN), U6.13 (GND), U6.17 (ThermalPad); also elsewhere on the board
unnamed: J2.1, U6.5 (BOUT2)
unnamed: J2.2, U6.7 (BOUT1)
unnamed: J3.1, U6.2 (AOUT1)
unnamed: J3.2, U6.4 (AOUT2)
unnamed: C3.2, U6.11 (VCP)
unnamed: C5.1, U6.14 (VINT)

Parts of its further copies:
C9, C16: 10 uF; C_1206_3216Metric_Pad1.33x1.80mm_HandSolder
C10, C17: 0.01 uF; C_0603_1608Metric_Pad1.08x0.95mm_HandSolder
C15, C18: 2.2 uF; C_0603_1608Metric_Pad1.08x0.95mm_HandSolder
J5, J6, J7, J8: Conn_01x02; Terminal_5mm
U11, U12: DRV8833PW; HTSSOP-16-1EP_4.4x5mm_P0.65mm_EP3x3mm

Connections of its further copies:
+10V: C9.1, C10.1, C16.1, C17.1, U11.12 (VM), U12.12 (VM); also elsewhere on the board
/AIN1: U11.16 (AIN1), U12.16 (AIN1); also elsewhere on the board
/AIN2: U11.15 (AIN2), U12.15 (AIN2); also elsewhere on the board
/BIN1: U11.9 (BIN1), U12.9 (BIN1); also elsewhere on the board
/BIN2: U11.10 (BIN2), U12.10 (BIN2); also elsewhere on the board
/H_BRIDGE_EN2: U11.1 (nSLEEP); also elsewhere on the board
/H_BRIDGE_EN3: U12.1 (nSLEEP); also elsewhere on the board
GND: C9.2, C15.2, C16.2, C18.2, U11.3 (AISEN), U11.6 (BISEN), U11.13 (GND), U11.17 (ThermalPad), U12.3 (AISEN), U12.6 (BISEN), U12.13 (GND), U12.17 (ThermalPad); also elsewhere on the board
unnamed: J5.1, U11.5 (BOUT2)
unnamed: J5.2, U11.7 (BOUT1)
unnamed: J6.1, U11.2 (AOUT1)
unnamed: J6.2, U11.4 (AOUT2)
unnamed: J7.1, U12.5 (BOUT2)
unnamed: J7.2, U12.7 (BOUT1)
unnamed: J8.1, U12.2 (AOUT1)
unnamed: J8.2, U12.4 (AOUT2)
unnamed: C10.2, U11.11 (VCP)
unnamed: C15.1, U11.14 (VINT)
unnamed: C17.2, U12.11 (VCP)
unnamed: C18.1, U12.14 (VINT)

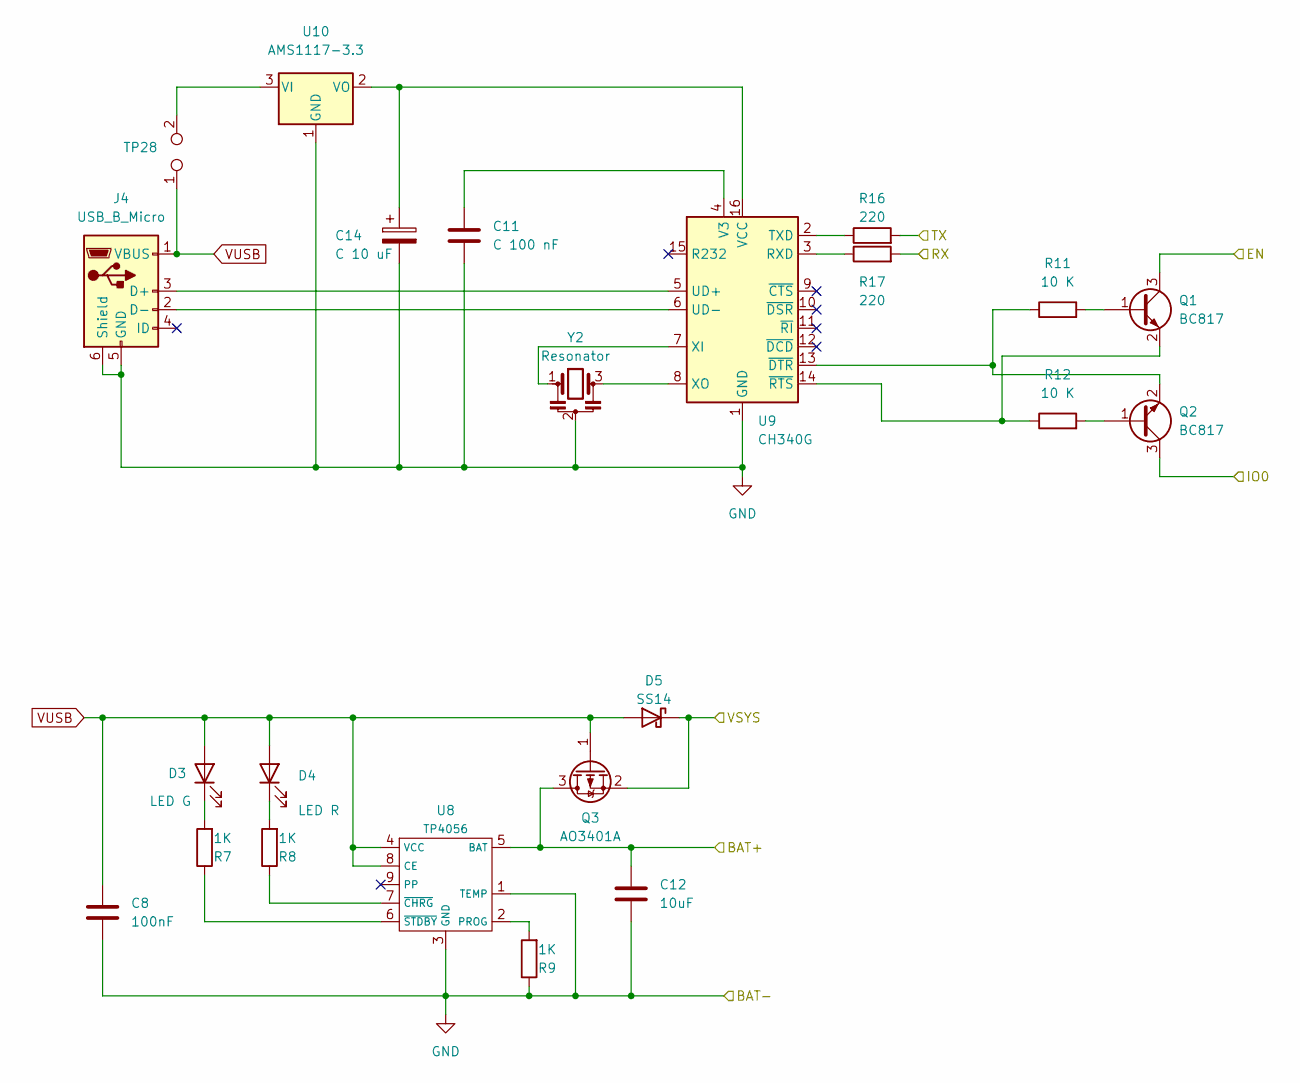
[picture p19: schematic usb.kicad_sch]

Parts:
C8: 100nF; C_0603_1608Metric_Pad1.08x0.95mm_HandSolder
C11: C 100 nF; C_0603_1608Metric_Pad1.08x0.95mm_HandSolder
C12: 10uF; C_0603_1608Metric_Pad1.08x0.95mm_HandSolder
C14: C 10 uF; C_0603_1608Metric_Pad1.08x0.95mm_HandSolder
D3: LED G; LED_D3.0mm_Clear
D4: LED R; LED_D3.0mm_Clear
D5: SS14; D_SMA_Handsoldering
J4: USB_B_Micro; USB_Micro-B_Molex-105017-0001
Q1, Q2: BC817; SOT-23
Q3: AO3401A; SOT-23
R7, R8, R9: 1K; R_0603_1608Metric_Pad0.98x0.95mm_HandSolder
R11, R12: 10 K; R_0603_1608Metric_Pad0.98x0.95mm_HandSolder
R16, R17: 220; R_0603_1608Metric_Pad0.98x0.95mm_HandSolder
TP28: TestPoint_2Pole; TestPoint_2Pads_Pitch2.54mm_Drill0.8mm
U8: TP4056; SOIC-8-1EP_3.9x4.9mm_P1.27mm_EP2.29x3mm
U9: CH340G; SOIC-16_3.9x9.9mm_P1.27mm
U10: AMS1117-3.3; SOT-223-3_TabPin2
Y2: Resonator; Resonator_SMD_Murata_CSTxExxV-3Pin_3.0x1.1mm_HandSoldering

Connections:
GND: C8.2, C11.2, C12.2, C14.2, J4.5 (GND), J4.6 (Shield), R9.1, U8.1 (TEMP), U8.3 (GND), U9.1 (GND), U10.1 (GND), Y2.2; also elsewhere on the board
IO0: Q2.3 (C); also elsewhere on the board
unnamed: D3.1 (K), R7.2
unnamed: D4.1 (K), R8.2
unnamed: J4.3 (D+), U9.5 (UD+)
unnamed: J4.2 (D-), U9.6 (UD-)
unnamed: Q1.1 (B), R11.2
unnamed: Q1.2 (E), R12.1, U9.14 (~RTS)
unnamed: Q2.1 (B), R12.2
unnamed: Q2.2 (E), R11.1, U9.13 (~DTR)
unnamed: R9.2, U8.2 (PROG)
unnamed: R8.1, U8.7 (~CHRG)
unnamed: R7.1, U8.6 (~STDBY)
unnamed: R17.1, U9.3 (RXD)
unnamed: R16.1, U9.2 (TXD)
unnamed: C11.1, U9.4 (V3)
unnamed: U9.7 (XI), Y2.1
unnamed: U9.8 (XO), Y2.3
unnamed: TP28.2, U10.3 (VI)
unnamed: C14.1, U9.16 (VCC), U10.2 (VO)
RX: R17.2; also elsewhere on the board
TX: R16.2; also elsewhere on the board

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
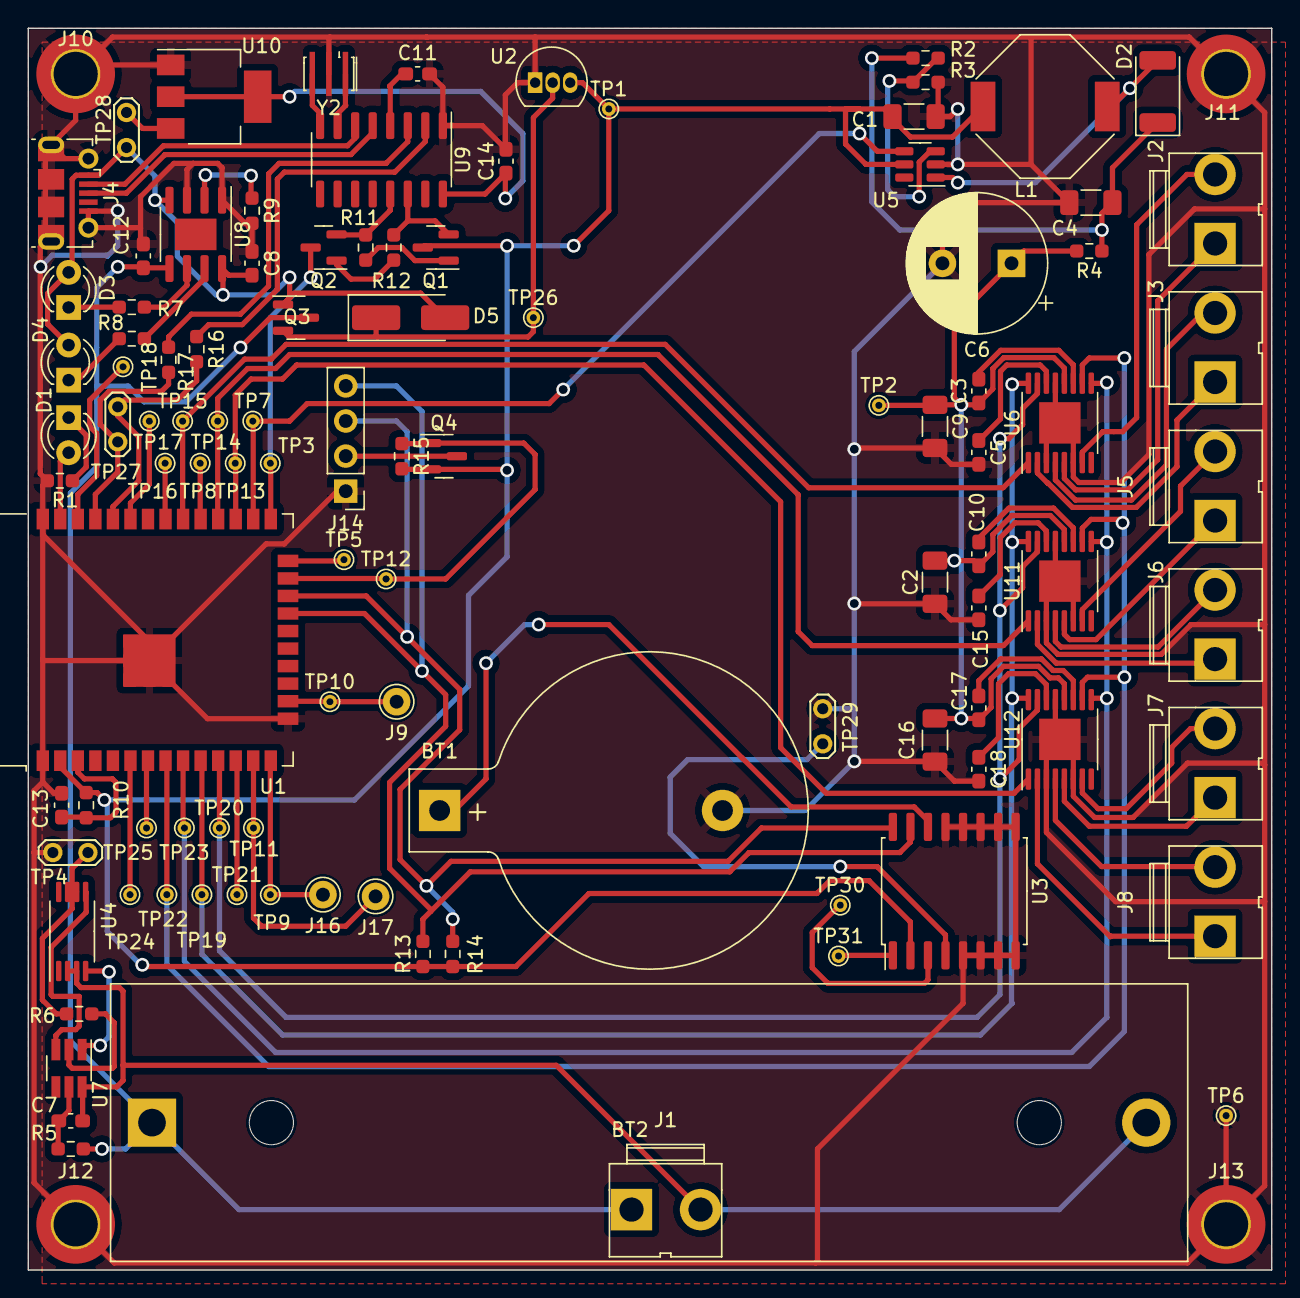
[picture p20: board garden_valve_controller.kicad_pcb from above]

Board: 2 copper layers, 90.0 x 89.9 mm, 107 parts (0 on the bottom side), 84 nets.
