giovannitarter/automatic_irrigation/firmware/project/src/garden_valve_controller.h

#ifndef __GVC_GDEFINES__
#define __GVC_GDEFINES__


#ifndef STASSID
#define STASSID ""
#error STASSID not defined
#endif

#ifndef STAPSK
#define STAPSK  ""
#error STAPSK not defined
#endif

#ifndef ESPSERVER
#define ESPSERVER  "espserver"
#endif

#ifndef ESPPORT
#define ESPPORT  "8100"
#endif

#ifndef NTPSERVER
#define NTPSERVER  "pool.ntp.org"
#endif

#define PIN_LATCH GPIO_NUM_19

#define PIN_DISPLAY_EN GPIO_NUM_15
#define PIN_LED_ACT GPIO_NUM_23

#define PIN_TOUCH_1 GPIO_NUM_13
#define PIN_TOUCH_2 GPIO_NUM_35
#define PIN_TOUCH_3 GPIO_NUM_34

#define PIN_STEP_UP_EN GPIO_NUM_4

#define PIN_H_BRIDGE_EN_1 GPIO_NUM_18
#define PIN_H_BRIDGE_EN_2 GPIO_NUM_17
#define PIN_H_BRIDGE_EN_3 GPIO_NUM_16

#define PIN_H_BRIDGE_AIN_1 GPIO_NUM_25
#define PIN_H_BRIDGE_AIN_2 GPIO_NUM_26
#define PIN_H_BRIDGE_BIN_1 GPIO_NUM_33
#define PIN_H_BRIDGE_BIN_2 GPIO_NUM_32


#define PIN_SX_M0 GPIO_NUM_25
#define PIN_SX_M1 GPIO_NUM_26
#define PIN_SX_RX GPIO_NUM_33
#define PIN_SX_TX GPIO_NUM_32
#define PIN_SX_AUX GPIO_NUM_27


#define SCHEDULE_MAXLEN 256

#define BOOT_DELAY 1 //sec

#define EVT_TOLERANCE 10 //sec
#define SLEEP_MAX 60 * 60 * 2 //sec
#define SLEEP_MIN 5  //sec


#define OP_NONE  0x00
#define OP_SKIP  0x10
#define OP_OPEN  0x11
#define OP_CLOSE 0x12
    
#define TOUCH_THRESHOLD 80


#define TIME_MIN 1640995200

#define ADDR_CNT 0x01

#define ADDR_CHECK 0x02
#define VAL_CHECK 0b0101010101

#define ADDR_NEXTOP 0x03
#define TZ "CET-1CEST,M3.5.0/2,M10.5.0/3"
#define SOLENOID_DRV_NR 6

void print_wakeup_reason(esp_sleep_wakeup_cause_t wakeup_reason);

uint8_t decode_action(uint8_t msg_action);
size_t read_schedule(char * buffer, size_t buflen);
void rtc_set_time(time_t time_p);
time_t rtc_get_time();

void hibernate();


#endif
