giovannitarter/automatic_irrigation/firmware/project/src/helpers.cpp

#include <Arduino.h>
#include <LittleFS.h>

#include "helpers.h"


void print_wakeup_reason(esp_sleep_wakeup_cause_t wakeup_reason){

    switch(wakeup_reason){

      case ESP_SLEEP_WAKEUP_EXT0:
          Serial.println("Wakeup caused by external signal using RTC_IO");
          break;

      case ESP_SLEEP_WAKEUP_EXT1:
          Serial.println("Wakeup caused by external signal using RTC_CNTL");
          break;

      case ESP_SLEEP_WAKEUP_TIMER:
          Serial.println("Wakeup caused by timer");
          break;

      case ESP_SLEEP_WAKEUP_TOUCHPAD:
          Serial.println("Wakeup caused by touchpad");
          break;

      case ESP_SLEEP_WAKEUP_ULP:
          Serial.println("Wakeup caused by ULP program");
          break;

      default:
          Serial.printf("Wakeup was not caused by deep sleep: %d\n",wakeup_reason);
          break;
    }
    Serial.printf("\r");
}


size_t read_schedule(char * buffer, size_t buflen) {

    size_t res = 0;

    Serial.println("read schedule");

    LittleFS.begin(true);
    if (LittleFS.exists("/schedule.txt")) {

        File f = LittleFS.open("/schedule.txt", "r");
        res = f.readBytes(buffer, buflen);
        f.close();
    }
    LittleFS.end();

    return res;
}


void get_chip_id(char * text_id, size_t len) {

    uint64_t chipid;
    chipid = ESP.getEfuseMac();
    snprintf(text_id, len,
        "%04X%08X",
        (uint16_t)(chipid >> 32),
        (uint32_t)chipid
    );
}
