giovannitarter/automatic_irrigation/(commit log)

2023-05-14 initial
    - committing board printed on 2023-05-13
    [battery.kicad_sch, garden_valve_controller.kicad_pcb, garden_valve_controller.kicad_sch, solenoid_driver.kicad_sch, usb.kicad_sch]
2023-06-12 firmware initial
    [schedule.csv]
2023-06-21 using esp32 gpio pin facilities
2023-07-23 second printed board (mk2)
    [automatic_irrigation_project.csv, automatic_irrigation_project.kicad_pcb, automatic_irrigation_project.kicad_sch, battery.kicad_sch, garden_valve_controller.csv, garden_valve_controller.kicad_pcb, garden_valve_controller.kicad_sch, power_latch.kicad_sch]
2023-07-25 regenerate schematic plots and bom
    [automatic_irrigation_project.csv]
